diferential/tt-rf-playground/journal.org

* Planning - tt08 - PLL
** TODO LVS checks - scripts
** TODO LVS checks - run on top level PLL block
** TODO macro jtag 8 bits serial
** TODO macro divisor and control circuit
** TODO layout feedback divisor
** TODO layout CP filter caps bank
** TODO layout main PLL
** DONE layout charge pump
CLOSED: [2024-09-03 Tue 10:13]
** DONE layout phase detector
CLOSED: [2024-09-01 Sun 20:06]
** DONE layout opamp3hv
CLOSED: [2024-09-02 Mon 23:40]
:LOGBOOK:
CLOCK: [2024-09-02 Mon 19:40]--[2024-09-02 Mon 23:36] =>  3:56
:END:
** DONE layout current sources
CLOSED: [2024-08-23 Fri 09:14]
- [X] root currents
- [X] adjust local cell
** DONE layout pll gates
CLOSED: [2024-08-23 Fri 09:10]
- [X] inv1
- [X] pll_invresfb
- [X] nand
- [X] nor
** DONE layout lvl shifter
CLOSED: [2024-08-23 Fri 09:10]

* Planning - tt08 - RF mixer
* Planning - tt08 - DRAM cell
** TODO layout array with sense amps
** TODO layout boundary tap cell
** TODO control circuit
- [ ] row decoder
- [ ] column DFFs
** DONE layout 3T cell
** DONE some simulations with capacitance
** DONE schematic for sense amplifier strongarm latch
* Planning - tt08
** TODO Submit something early
** TODO Pins plan
** TODO LVS top level check
* Journal entries
** <2024-06-30 Sun> dram testing - 1T1C
- all sorts of tests done over the last weeks
- hard to get large enough capacitance .. although did not account for diffusion capacitance that much and there could be more gains with that
- parasitic capacitance pulls up/down when bit line changes
- close-to-cell tiny differential pair writing to differential next in line, keep a chain
- seemed like a good idea but upon testing with mismatch there is a large probability that the VT differences will ruin the first amplifier in chain.
** <2024-06-30 Sun> dram testing - 3T - alpha, beta, charlie
- 3T cell seems most stable and promising
*** capacitance and error margins
- capacitance from bit lines to storage capacitor is pretty large
  - 0 state is most susceptible to be brought up past VT
  - have to be careful *which one (BL or BLB) is closer to VG*
  - if BLB is the write line for VG, keep it farther away from VG
  - when BLB goes back to precharge from the 0 write state it will pull VG up
  - limiting the sense preload time (RD high prior to sense amplifier turn-on) may also lower the amount of capacitance interference (though this one feedback sort of is self-limiting - by the time it is problematic the bit lines have seen a big swing already). we have to stop read time quick enough that we preserve a difference -- otherwise the other bit line has time to catch up and lower our difference between BL/BLB.
- wide margin against errors, differential pair VS shared would seem to guard against that more
- [2024-07-01 Mon] limiting preload voltage protects against misreading 0 and improves margin, up to 0.7 VG-VGB margin now with 1.2 preload instead of 1.8.
*** layout
- tried alpha, beta, charlie and in trymosfets.mag
- all horizontal 2 cells seems like the best with 3.6um x 1.7um for pair of cells
- stacked pairs vertically did not scale well as word lines need one direction and bitlines the other
- need *tap cells* -- it looks like rule is 6um for tap distance, with only some small areas allowed to be 15um if marked as low tap density.
  - tap cells as rows seem like a good and easy strategy .. some 1.7um height means 6 cell rows are 10.2 - well below 12um. Each cell will be half-distance that from a tap cell so below 12um.
** <2024-07-01 Mon> DRC / layout rules ruler
- in trymosfets.mag placed some atomic via sizes between levels to see the minimal sizes on a 0.05um grid (rounding up sizes as needed)
- it would probably be a good idea to move these out into their own mag file for reference
** <2024-07-21 Sun> PLL testing. inverter
- lots of testing for PLL
*** charge pump for PLL after PFD
- charge pump noise seems better with Resistor and VOUT inverted
  - PLL CP without buffer yields low vout around 0.8V
  - not enough power from CP and opamp2 buffer caps around 1.2V
  - may be easiest to CP up to 5V or such and then buffer
*** opamp2
- using native nmos transistors yields good response all the way pretty close to VSS
*** level conversion needed post VCO otherwise DFF won't divide frequency
- VCO output levels can be some 0.5-0.6V only
- tried to use a differential amplifier and some cross-coupled feedback like a sense amplifier
- but it was finicky to get right
- resistor feedback inverter works really well and is virtually no-tune-needed
- coupling capacitor is needed
- resistor feedback and coupling capacitor can get pretty large in area .. for some applications multiple stages are smaller and may be better
*** some oscillation seen in PLL
- may need to tune feedback loop, thinking of doing it dynamically - when around lock point change feedback ratio
- noise after charge pump buffer opamp is much higher than CP output, have to look into this
*** Inverter resistor FB size reduction
- used a PMOS LVT with ~1.4-1.6 gate voltage instead of a resistor
- much smaller size and very good response
- since frequency is VCO frequency, may be able to also reduce coupling capacitor but already 5x5 is not too bad
