diferential/tt-rf-playground/(commit log)

2024-04-13 Schematic and test bench for opamp1 and vbias1.
    - opamp1 is just a differential pair now
    [gilbert_mixer.sch, opamp1.sch, tb_opamp1.sch, tb_vbias1.sch, vbias1.sch]
2024-04-13 Route vbias1
    [vbias1.sch]
2024-04-13 Attempt to fix pin ordering for vbias1 for LVS.
    [vbias1.sch]
2024-04-14 Route vbias on main project to make gds.
    [opamp1.sch]
2024-04-18 Add idac1 schematics and spice tests.
    [idac1.sch, idac1cell.sch, tb_idac1.sch, tb_idac1cell.sch]
2024-04-18 Add Pll1 test bench.
    [tb_pll1.sch]
2024-04-18 Make iopin
    [idac1.sch]
2024-04-18 Shrink transistors in idac. Update tb_pll1 and check it in.
    [idac1cell.sch, tb_pll1.sch]
2024-04-18 Idac1 cell routing
    [idac1cell.sch]
2024-04-19 Route and add ports to idac1. Still needs output transistors.
    [idac1.sch, tb_idac1.sch]
2024-04-19 LVS fixes for idac1.
    [idac1.sch, idac1cell.sch]
2024-04-19 Add bigger transistors for gilbert mixer.
    [tb_gilbert_mixer.sch]
2024-04-19 Update GDS with strapped pins to VGND. Also fix short to GND from IOUT.
    Also include gilbert mixer partially routed.
2024-04-26 Fix spice path.
    [tb_gilbert_mixer.sch]
2024-04-26 Update documentation.
    [tb_idac1cell.sch]
2024-05-19 Layout gilbert mixer.
    [tb_gilbert_mixer.sch, tb_opamp1_bigload.sch, tb_pll1.sch]
2024-06-01 Strap unused pins to GND.
2024-06-30 Various experiments.
    For trymosfets.mag -- some DRC and dram cell tests.
    [tb_em_dram_cell_sourcecap1.sch, tb_em_dram_cell_sourcecap2.sch, tb_em_pfet_nfet.sch, tb_em_pfet_nfet_diff.sch, tb_em_pfet_nfet_v1cell.sch, tb_pll1_bk.sch, test_sweep_mos_diffpair.sch]
2024-07-01 DRAM 3T charlie cell and test bed for interference.
    [tb_dram3t_cap_interference.sch]
2024-07-01 Change dram3t test bench to use non-lvt transistor for storage.
    [tb_dram3t_cap_interference.sch]
2024-07-02 Swap BL/BLB so VG is under BL to improve write precharge isolation.
    On write of a 0 the BLB is our write line to set VG to 0/low.
    After WR is done BLB is pulled up and the capacitive coupling
    will pull up VG. Making BLB farther lowers the coupling.
2024-07-02 Fix dram3t interference xschem file - names were wrong.
    Change up with some extracted values for caps and lower precharge voltage.
    Export some SVG files.
    [tb_dram3t_cap_interference.sch]
2024-07-09 Simulations for strong arm latch and inverter.
    [tb_pll1.sch, tb_pll_inv1.sch, tb_strongarm_latch1.sch]
2024-07-09 Lower PMOS transistor sizes for strongarm latch.
    [tb_strongarm_latch1.sch]
2024-07-10 Simulate multiple offsets in strongarm latch.
    [tb_strongarm_latch1.sch]
2024-07-11 Add mosfets and pll_inv1.mag
    [tb_pll_inv1.sch]
2024-07-20 Add PFD.
    [pll_cp_alpha.sch, pll_cp_beta.sch, pll_inv1.sch, pll_inv1_buf.sch, pll_nand.sch, pll_nor.sch, pll_pfd.sch, tb_dram3t_cap_interference.sch]
2024-07-21 Opamp2 and PLL2 experiment locking around 500Mhz
    [opamp2.sch, pll_cp_alpha.sch, pll_cp_beta.sch, tb_opamp_buf1.sch, tb_pll2.sch, tb_pll3.sch]
2024-07-21 Change to pll_inv1 and lock test around 800 Mhz
    [tb_pll3.sch]
2024-07-22 Change up-level convert with resistor feedback inverter.
    - also add notes for PLL3 test bench
    [opamp2.sch, tb_invfb_upconvert.sch, tb_opamp_buf1.sch, tb_pll3.sch]
2024-07-22 Inverter FB with mosfet instead of resistor.
    [tb_invfb_upconvert.sch]
2024-07-27 Add opamp3 and ac response test.
    [opamp3.sch, tb_opamp_buf1.sch]
2024-07-28 PLL3 locked around 1Ghz
    [pll_cp_alpha.sch, tb_pll3.sch]
2024-07-29 Charlie charge pump - limited per cycle with short cap clock input.
    [tb_pll_cp_charlie.sch]
2024-08-01 Small edits.
    [opamp2.sch, pll_cp_alpha.sch, pll_pfd.sch, tb_pll3.sch, tb_pll_cp_alpha.sch]
2024-08-01 High voltage opamp and inverter.
    - also add some existing pll test benches and the charlie charge pump
    - started on the high voltage pll test bench, missing some voltage
    conversions
    [opamp3hv.sch, pll_cp_charlie.sch, pll_cp_delta_hv.sch, pll_inv2_hv.sch, tb_cp_boost1.sch, tb_opamp_buf2_hv.sch, tb_pll4_cpdelta_hv.sch, tb_pll_cp_delta_hv.sch]
2024-08-02 Add lo to hi level shifter lohi1 schematic.
    [lvl_shift_lohi1.sch]
2024-08-02 PLL4 locks around 500mhz albeit with some jitter oscillation
    - opamp3hv switched to native 3v nfet, swings 0 to 2V on a 3.3V rail
    sufficient for pll buffer
    [opamp3hv.sch, pll_cp_delta_hv.sch, tb_opamp_buf2_hv.sch, tb_pll4_cpdelta_hv.sch]
2024-08-02 Change charge pump delta with one less cascode transistor.
    - also moves the up/down signal below the cascode
    - output can swing rail to rail now.
    [pll_cp_delta_hv.sch, tb_pll4_cpdelta_hv.sch, tb_pll_cp_delta_hv.sch]
2024-08-03 PLL4 lock at 1Ghz
    - change the charge pump to max out a capacitor
    - post lock condition, only adjust every X cycles to dampen
    jitter/oscillation
    [pll_cp_delta_hv.sch, tb_pll4_cpdelta_hv.sch, tb_pll_cp_delta_hv.sch]
2024-08-03 Pll4 around 320mhz
    [pll_cp_delta_hv.sch, tb_pll4_cpdelta_hv.sch]
2024-08-05 Add rootcurrents for 60uA source.
    [lvl_shift_lohi1.sch, root_currents1.sch, root_currents1outp.sch, tb_vbias1.sch]
2024-08-06 RootCurrents import test bench and tweaks.
    - Lower transitor sizes.
    - Test compliance <2V clamping.
    [root_currents1.sch, root_currents1outp.sch, tb_root_currents1.sch]
2024-08-08 Add current mirror adjust cell schematic and test bench.
    [cmirror_adj1.sch, tb_cmirror_adj1.sch, tb_pll4_cpdelta_hv.sch]
2024-08-09 Add pad model.
    [pad_model.sch, tb_pad_model.sch]
2024-08-10 Mosfet feedback inverter experiments.
    [pll_inv1.sch, tb_invfb_upconvert.sch]
2024-08-11 Remove VNB from pll_inv1 and pll_inv1_buf.
    This was already shorted to VSS.
    [pll_inv1.sch, pll_inv1_buf.sch]
2024-08-11 Remove VPB/VNB from pllinv1.
    - only pll_inv1_buf from ring oscillator can use differen bias
    [pll_inv1.sch]
2024-08-11 Make pll_pfd reset for longer and stronger.
    - reset was spiking only very briefly on some simulations
    - remove VPB/VNB from PLL_NAND make power pins hidden
    - make the voltage restorer use a shorter resistor and 2x inverter in
    PLL4 test bench
    [pll_nand.sch, pll_pfd.sch, tb_pll4_cpdelta_hv.sch, tb_pll_pfd.sch]
2024-08-11 Make logic cells line up well and change up routing rail vertically.
2024-08-11 Layout pll_invresfb.
    - resistive feedback inverter
2024-08-23 Layout for root_currents1_3outs
    - also fixes on resistor values and lenghts
    - also fixes for logic gates removing VNB
    [opamp3hv.sch, pll_cp_delta_hv.sch, pll_nand.sch, pll_nor.sch, pll_pfd.sch, root_currents1.sch, tb_cmirror_adj1.sch, tb_opamp_buf2_hv.sch]
2024-09-02 Layout PLL PFD. Add PLL5 xschemrc
    - locks at 1GHz
    - moved PLL filter up in the PLL schematic instead of CP
    - get IREF as input pin for charge pump version echo
    [opamp3hv.sch, pll_cp_echo_hv.sch, pll_pfd.sch, tb_invfb_upconvert.sch, tb_pll5_cpecho_hv.sch]
2024-09-02 Use real current sources in PLL5.
    [tb_pll5_cpecho_hv.sch]
2024-09-02 PLL5 - add clamping and change bias circuitry.
    [opamp3hv.sch, tb_pll5_cpecho_hv.sch]
2024-09-03 Layout opamp3hv and pll_cp_echo_hv
    [opamp3hv.sch, pll_cp_echo_hv.sch, tb_pll5_cpecho_hv.sch]
2024-09-05 Lower cap sizes on PLL filter.
    [tb_pll5_cpecho_hv.sch]
2024-09-05 Split out tt08_pll from test bench.
    - also renumber pins in schematic all around
    [pll_inv1_buf.sch, pll_pfd.sch, tb_tt08_pll.sch, tt08_pll.sch]
2024-09-06 Layout inv1buf ring of 5.
    Add schematic for inverted with resistor feedback.
    [pll_invresfb.sch, tb_tt08_pll.sch, tt08_pll.sch]
2024-09-06 Layout for tt08 pll
    [tb_tt08_pll.sch, tt08_pll.sch]
2024-11-10 Add opamp3hv bias sink transistor.
    [opamp3hv_ibias.sch]
2024-11-10 Add root currents layout
2025-11-07 Add opamp3hvs which has a current sink as bias instead of voltage.
    [opamp3hv.sch, opamp3hvs.sch, tb_opamp_buf2_hv.sch]
2025-11-08 Move values to match schematic with mag for opamp3hv.
    - flipped caps around
    - changed M2 M6 M8 L to 0.5 and some Ws
    - AC analysis and performance looks broken/poor now
    [opamp3hv.sch, tb_opamp_buf2_hv.sch]
2025-11-09 Fixed test bench for opamp3hvs.
    - changed current levels
    - changed 1M resistor with 1Meg AC and 1K dc for AC analysis
    [opamp3hvs.sch, tb_opamp_buf2_hv.sch]
2025-11-09 Route opamp3hvs. Add rootcurrents1_routs.sch.
    [root_currents1_3outs.sch]
2025-11-09 Reorder ports matching layout and xschem.
    [lvl_shift_lohi1.sch, root_currents1outp.sch]
2025-11-09 Renumber ports.
    [opamp3hv.sch, opamp3hvs.sch]
2025-11-09 Commit straggling changes
    [opamp3hv_ibias.sch, tb_em_pfet_nfet.sch, tb_em_pfet_nfet_diff.sch, tb_em_pfet_nfet_v1cell.sch, tb_strongarm_latch1.sch, tt08_pll.sch]
